jockel71/RGB_HDMI_A600/AMIGA225.JPG

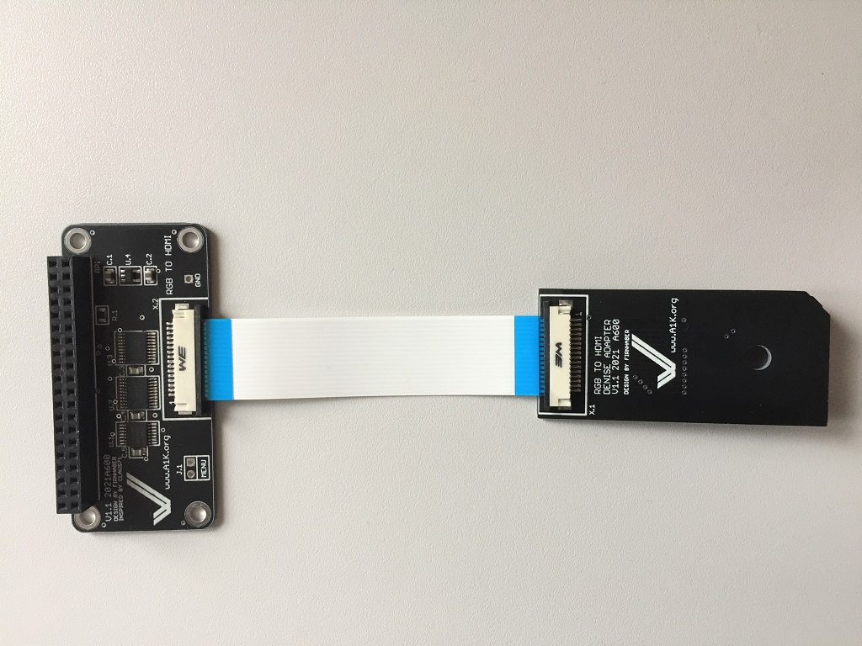
AMIGA225.JPG
