jockel71/RGB_HDMI_A600/AMIGA232.JPG

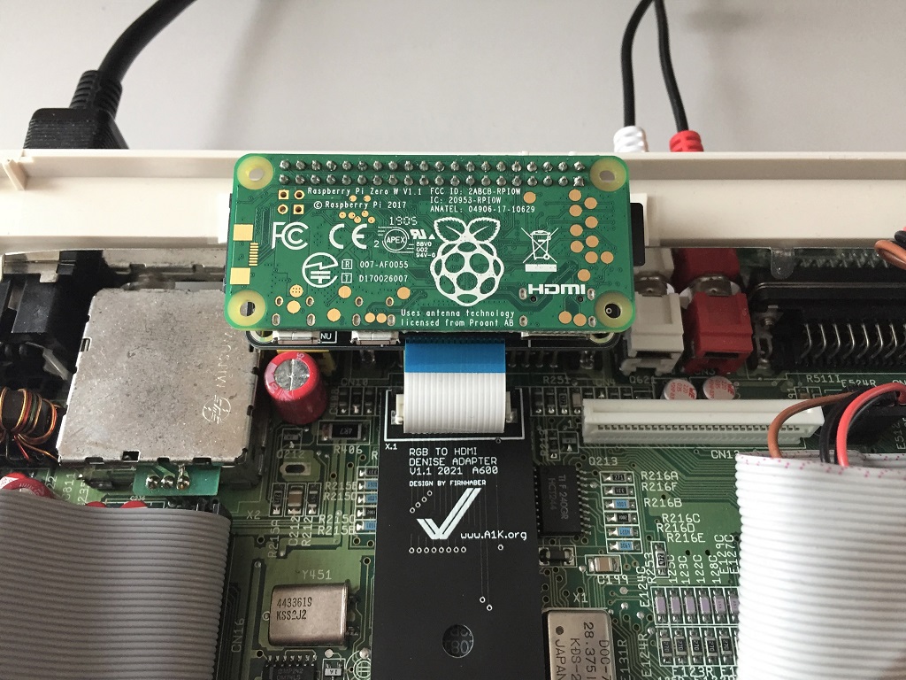
AMIGA232.JPG
