jockel71/RGB_HDMI_A600/AMIGA233.JPG

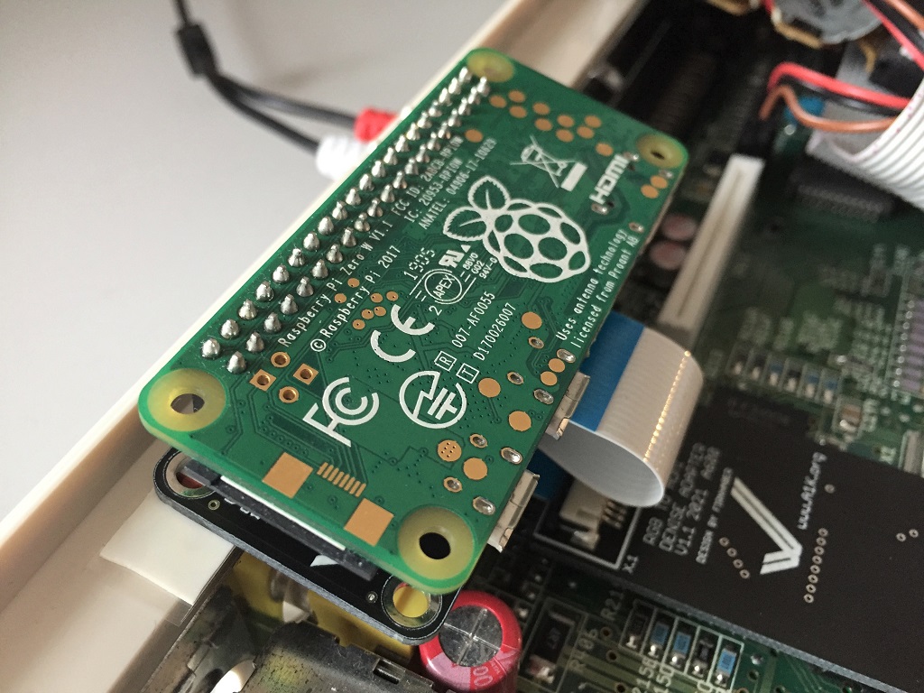
AMIGA233.JPG
