jockel71/RGB_HDMI_A600/Rev1_3/BOM_JLC.xlsx

Comment | Designator | Footprint | Mouser
10µF/10V | C.1, C.2 | 0805
100nF | C.3, C.4, | 0805
3k3 | R.1 | 0805
74LVC86APW | U.1 | TSSOP14 | 771-74LVC86APW-T
74LVC574APW | U.2, U.3 | TSSOP20 | 771-74LVC574APW-T
MIC5504-3.3M5-TR | U.4 | SOT23-5 | 998-MIC5504-3.3YM5TR
16 Pol | X.1, X.2 | FPC Header RM 1.0 | 649-F52R-1A7H1-11016
