jockel71/RGB_HDMI_A600/Rev1_3/BOM.xlsx

Menge | Wert | Device | Bauteile | Mouser
2 | 10µF/10V | 0805 | C.1, C.2
3 | 100nF | 0805 | C.3, C.4,
1 | 2 Pin | Pin Header 2.54 90°angle | J.1
1 | 3k3 | 0805 | R.1
1 | 40 Pin | 2 Row RPI Header | RPI | 710-61304021821
1 | 74LVC86APW | TSSOP14 | U.1 | 771-74LVC86APW-T
2 | 74LVC574APW | TSSOP20 | U.2, U.3 | 771-74LVC574APW-T
1 | MIC5504-3.3M5-TR | SOT23-5 | U.4 | 998-MIC5504-3.3YM5TR
1 | 52 Pin | PLCC socket SMD | U.5 | 517-8452-21A1-RK-TP
2 | 16 Pol | FPC Header RM 1.0 | X.1, X.2 | 649-F52R-1A7H1-11016
1 | 16 Pin | FPC Kabel RM 1.0 (127mm) |  | 538-15167-0319
