jockel71/RGB_HDMI_A600/HDMI_Acryl.DXF

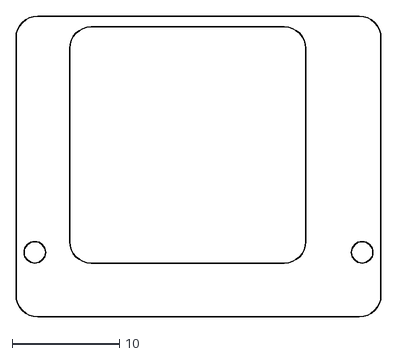
[picture p4: CAD file, 2021-08-13]
HDMI_Acryl.DXF
34.0 x 28.0
