jockel71/RGB_HDMI_A600/REV1.1/RGB_HDMI_schematic.pdf

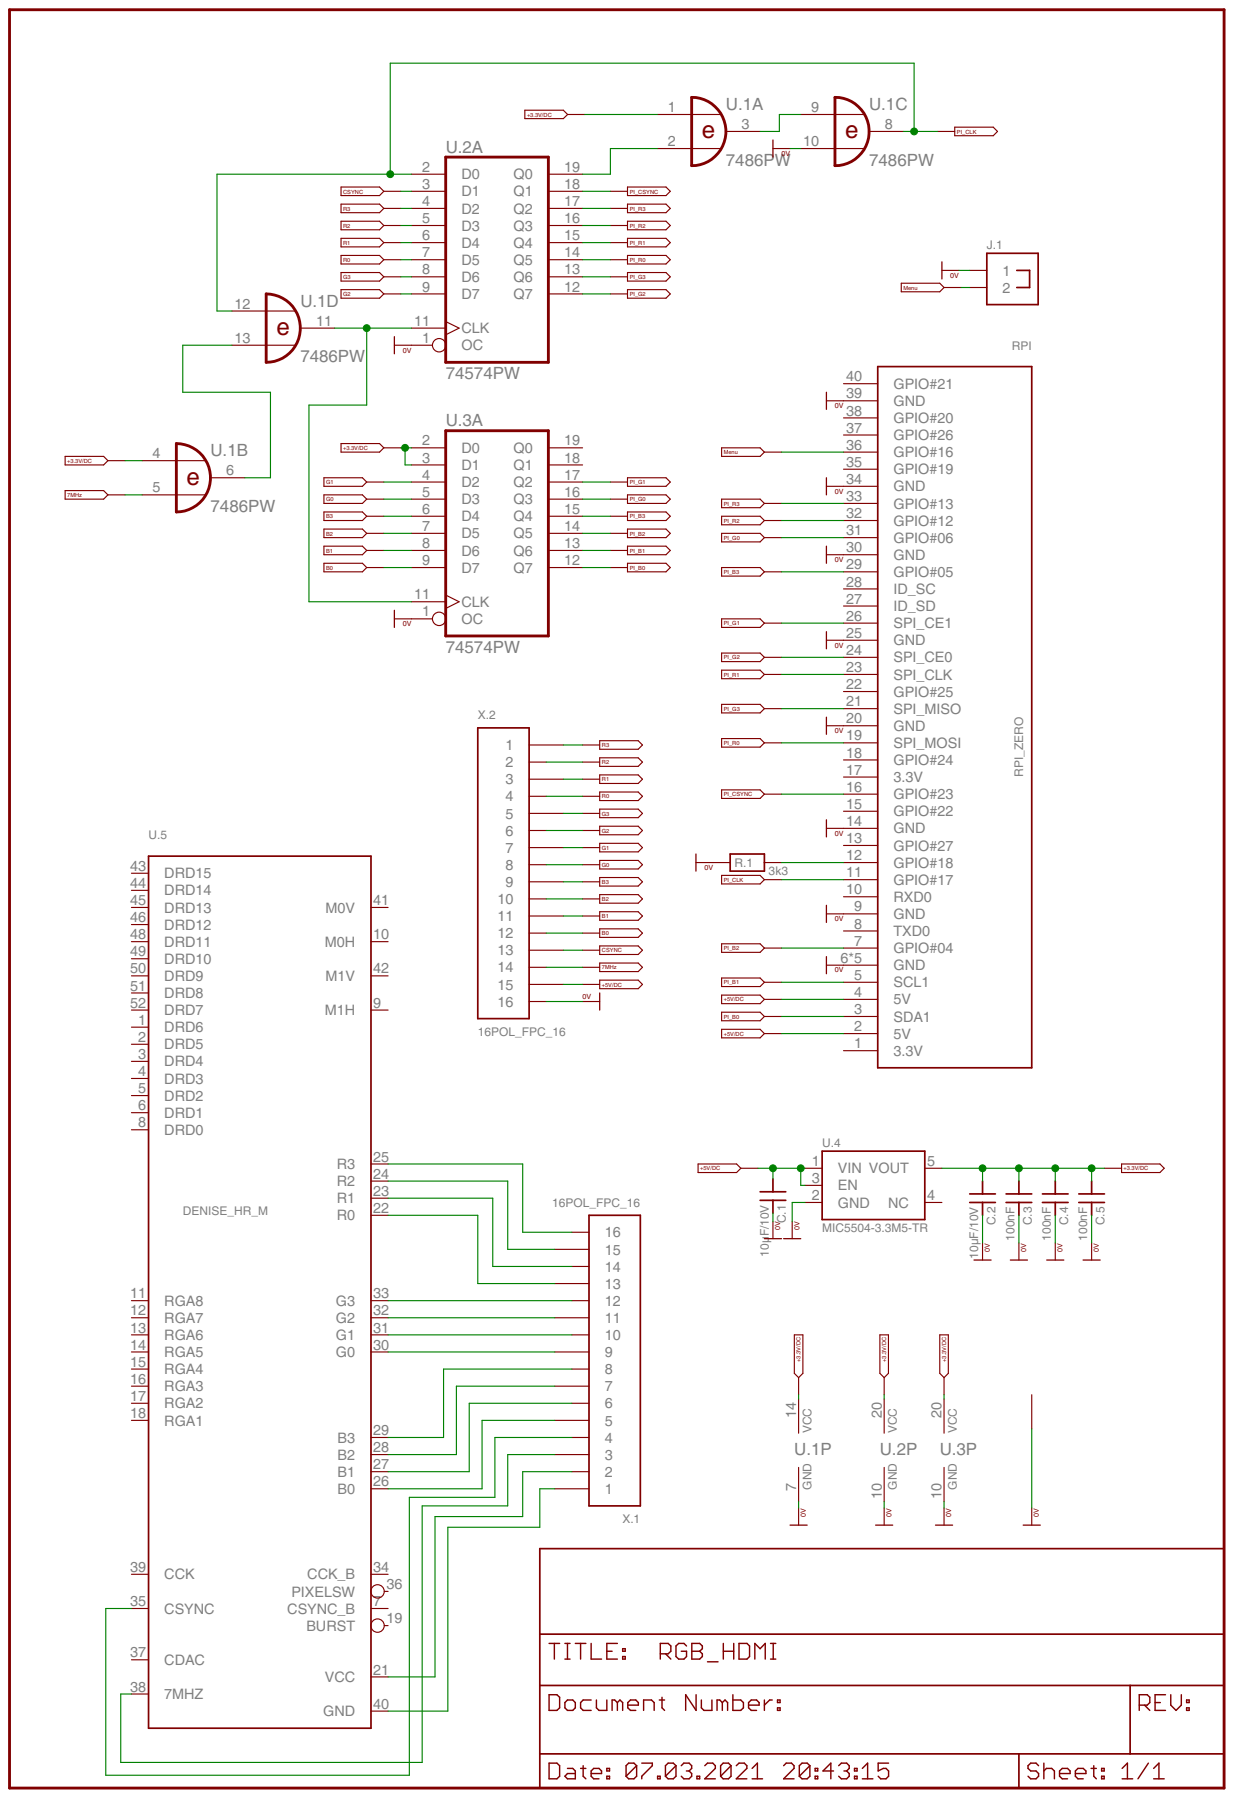
[picture p5: page 1]
