jockel71/RGB_HDMI_A600/Rev1_3/RGB_HDMI.brd

## EAGLE design Rev1_3/RGB_HDMI.brd (2021-07-07)

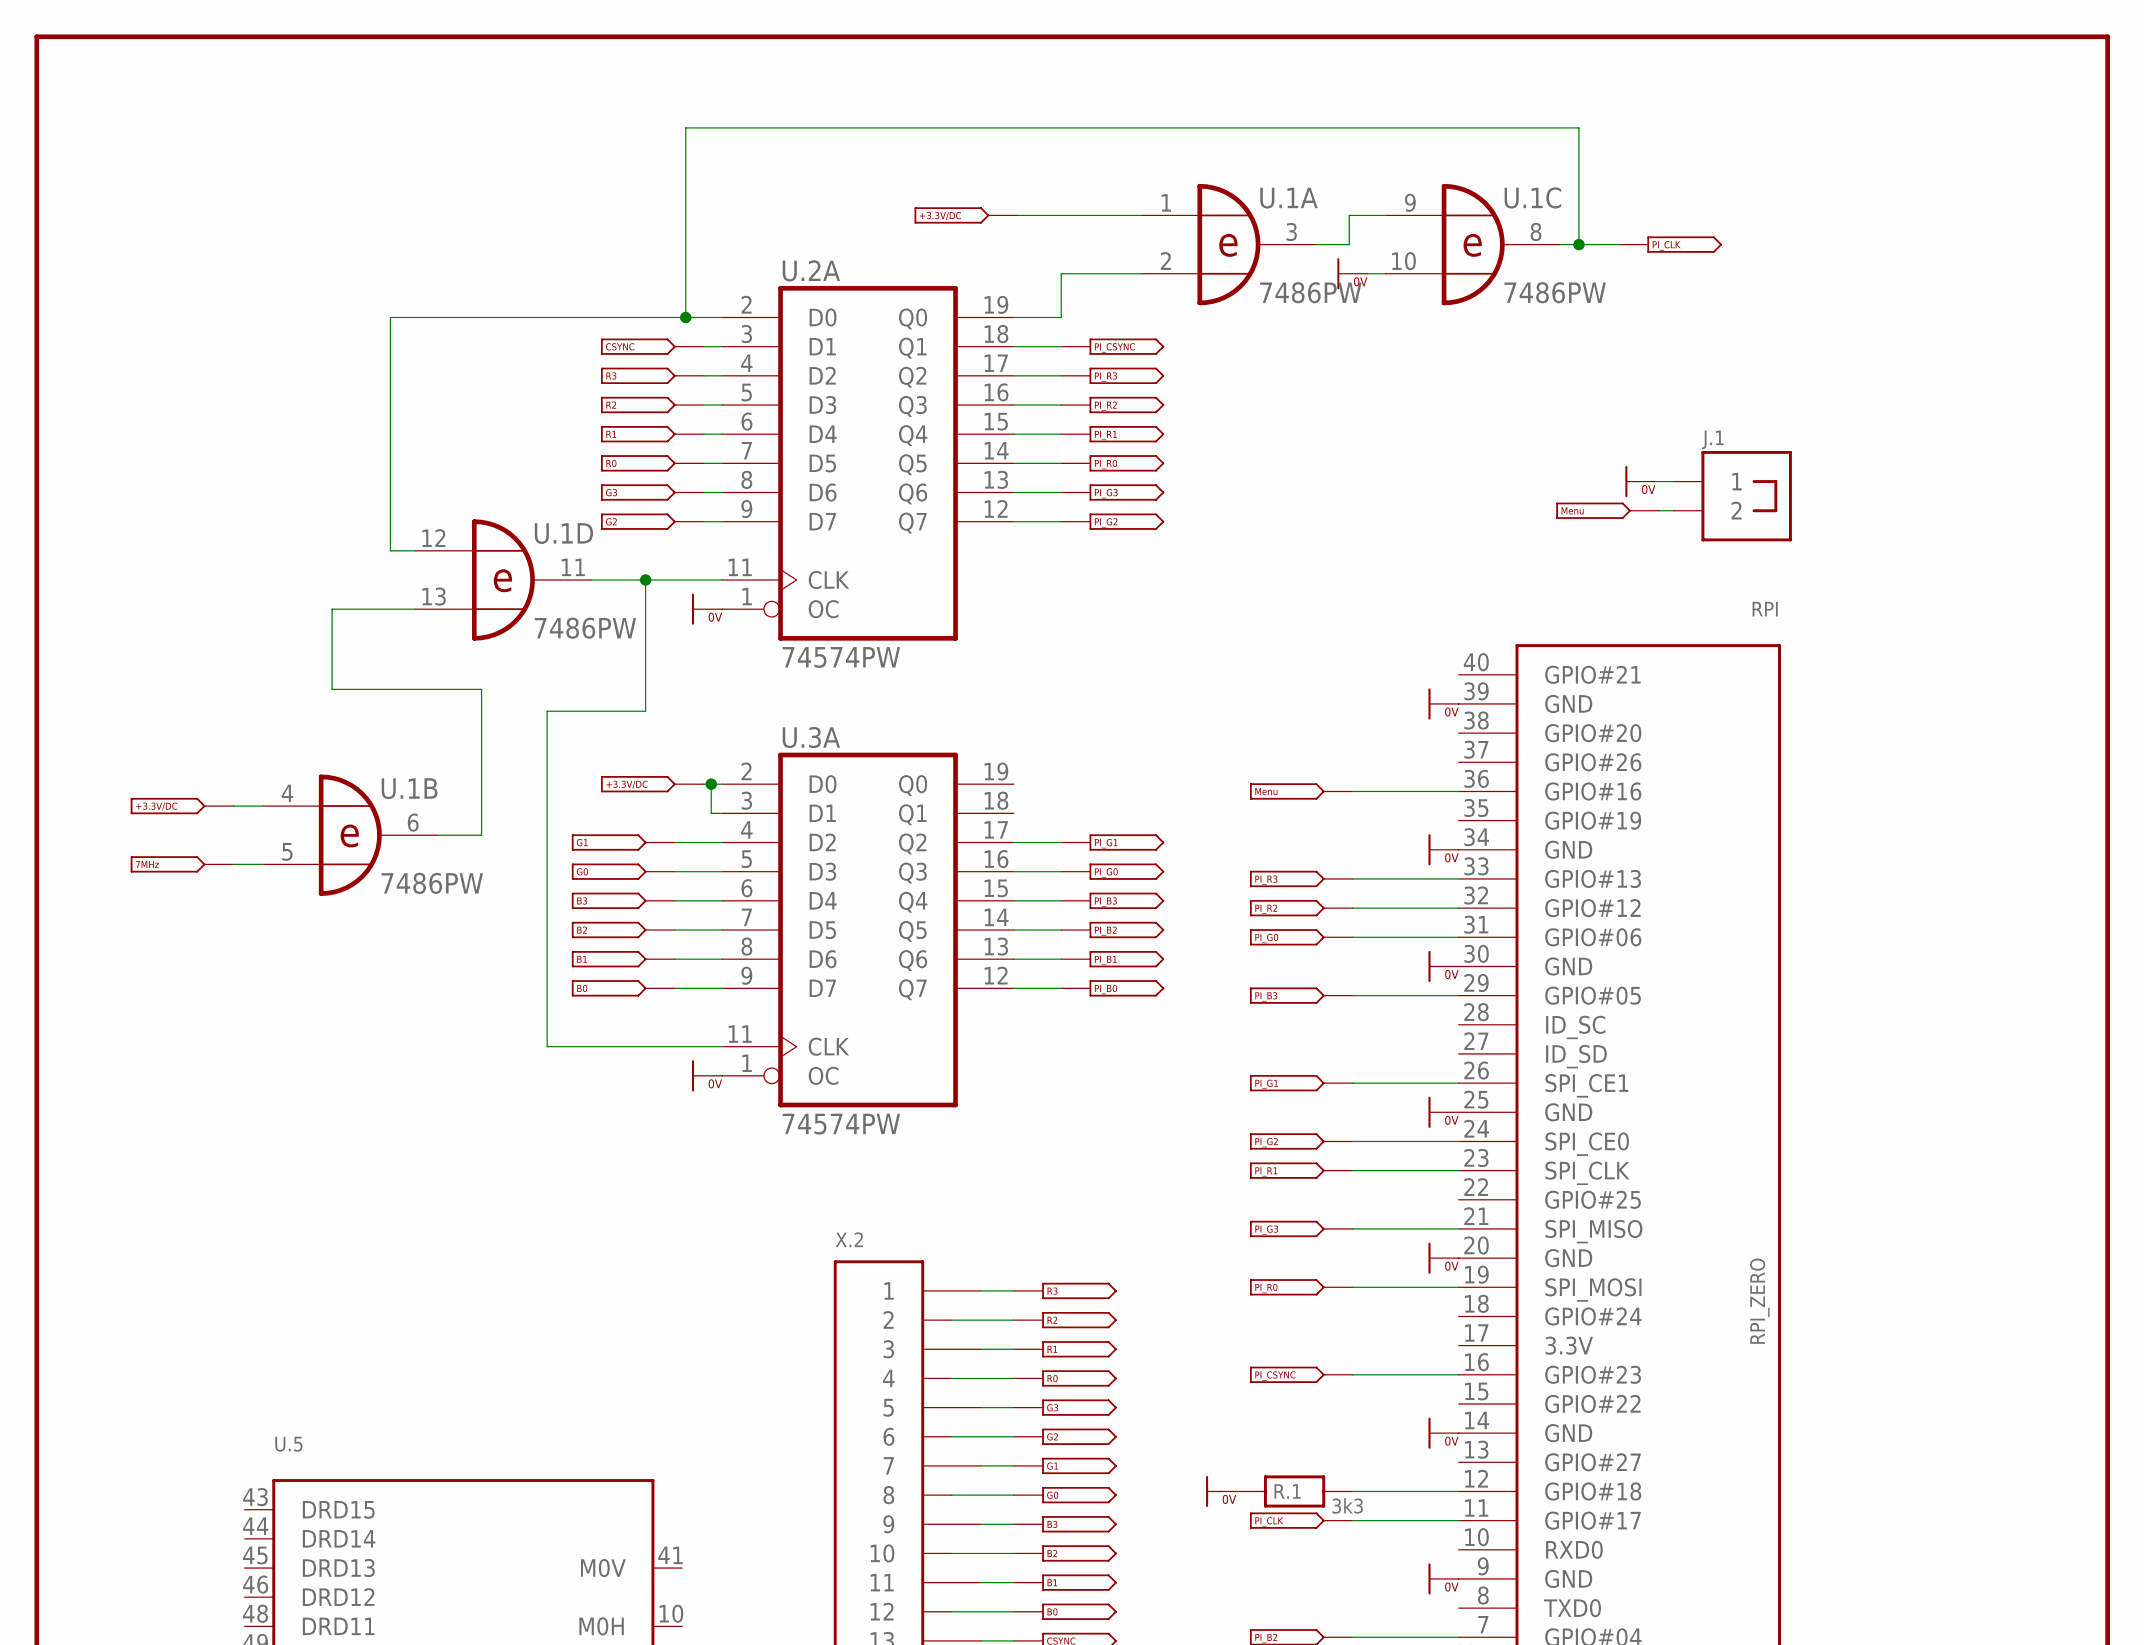
[picture p6: schematic RGB_HDMI.sch, part in row 1, column 1]

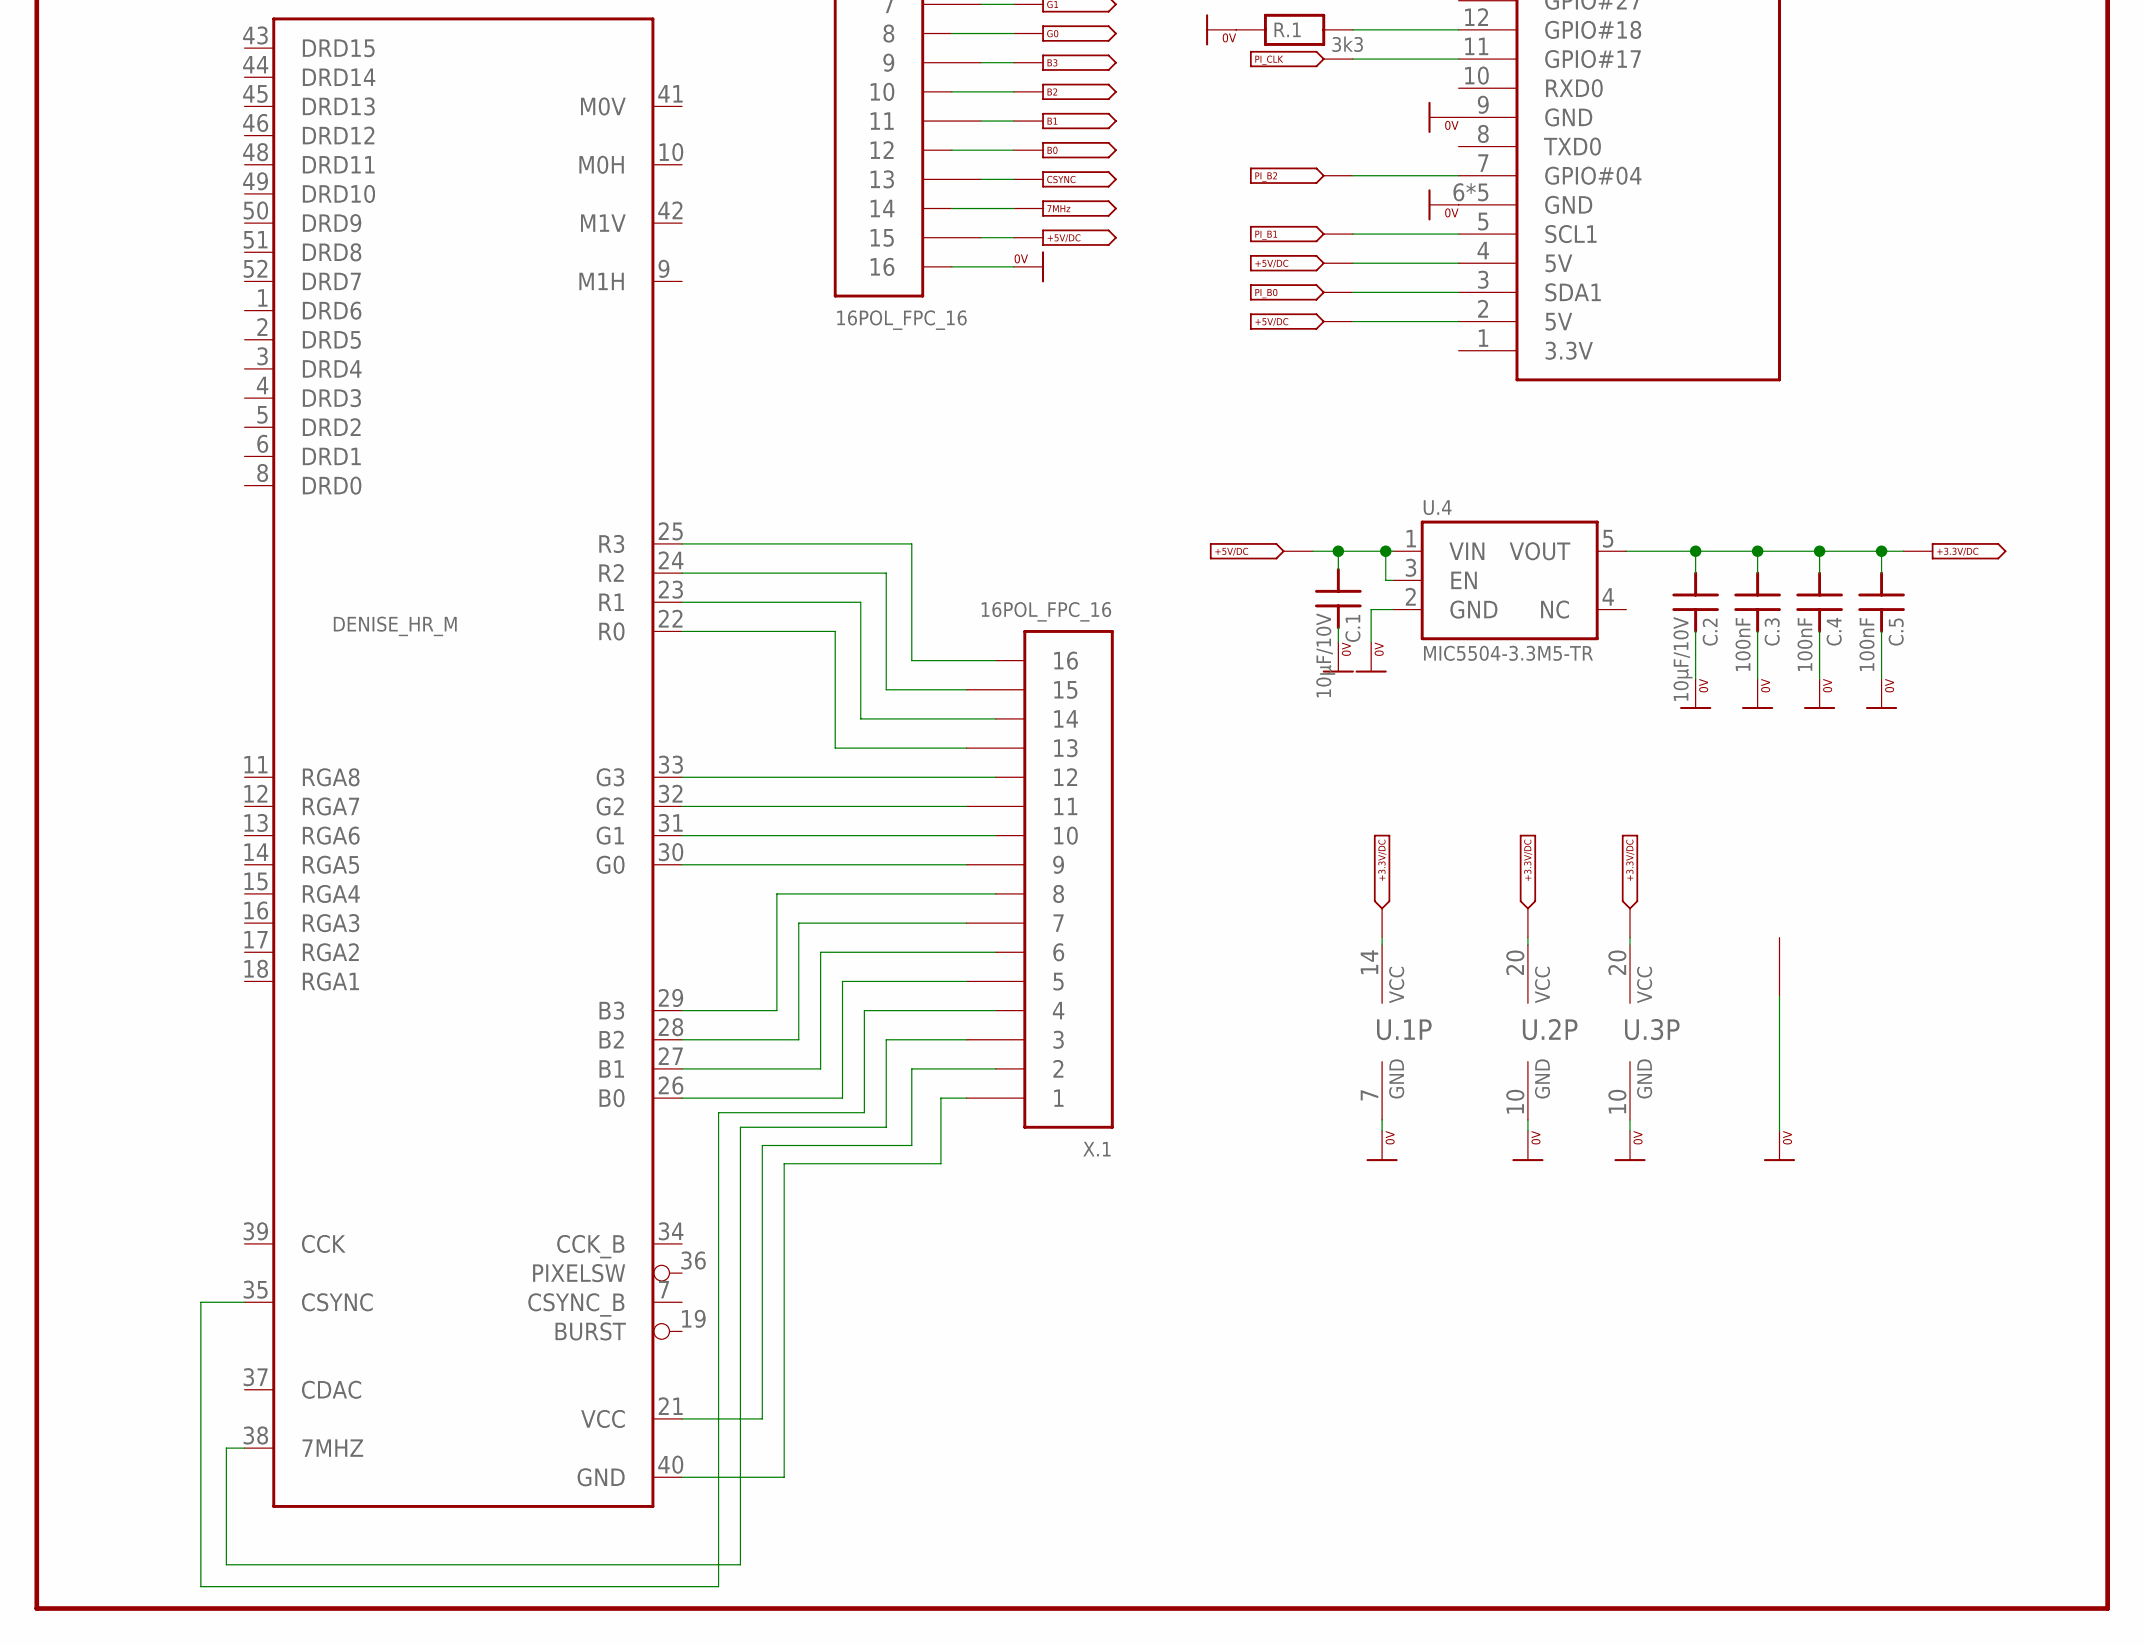
[picture p7: schematic RGB_HDMI.sch, part in row 2, column 1]

Parts:
C.1, C.2: 10µF/10V; 0805
C.3, C.4, C.5: 100nF; 0805
J.1: 2POLIG_1REIHIG
K.1: PAD_1,0SQ; 1,0SQ
R.1: 3k3; 0805
RPI: RPI_ZERO; RPI_ZERO_FULL
U.1: 7486PW; TSSOP14
U.2, U.3: 74574PW; TSSOP20
U.4: MIC5504-3.3M5-TR; SOT23-5
U.5: DENISE_HR_M; PLCC_52_MIRROR
X.1, X.2: 16POL_FPC_16; MOLEX_FPC_16

Connections:
0V: C.1.2, C.2.2, C.3.2, C.4.2, C.5.2, J.1.1, K.1.P$1, R.1.1, RPI.6 (GND), RPI.9 (GND), RPI.14 (GND), RPI.20 (GND), RPI.25 (GND), RPI.30 (GND), RPI.34 (GND), RPI.39 (GND), RPI.P$1 (GND), RPI.P$2 (GND), RPI.P$3 (GND), RPI.P$4 (GND), U.1.7 (GND), U.1.10 (I1), U.2.1 (OC), U.2.10 (GND), U.3.1 (OC), U.3.10 (GND), U.4.2 (GND), X.2.16
7MHZ: U.1.5 (I1), X.2.14
+3.3V: C.2.1, C.3.1, C.4.1, C.5.1, U.1.1 (I0), U.1.4 (I0), U.1.14 (VCC), U.2.20 (VCC), U.3.2 (D0), U.3.3 (D1), U.3.20 (VCC), U.4.5 (VOUT)
+5V: C.1.1, RPI.2 (5V), RPI.4 (5V), U.4.1 (VIN), U.4.3 (EN), X.2.15
B0: U.3.9 (D7), X.2.12
B1: U.3.8 (D6), X.2.11
B2: U.3.7 (D5), X.2.10
B3: U.3.6 (D4), X.2.9
CSYNC: U.2.3 (D1), X.2.13
G0: U.3.5 (D3), X.2.8
G1: U.3.4 (D2), X.2.7
G2: U.2.9 (D7), X.2.6
G3: U.2.8 (D6), X.2.5
GND: U.5.40 (GND), X.1.1
MENUE: J.1.2, RPI.36 (GPIO#16)
unnamed: U.1.6 (O), U.1.13 (I1)
unnamed: U.5.25 (R3), X.1.16
unnamed: U.5.24 (R2), X.1.15
unnamed: U.5.23 (R1), X.1.14
unnamed: U.5.22 (R0), X.1.13
unnamed: U.1.11 (O), U.2.11 (CLK), U.3.11 (CLK)
unnamed: U.1.2 (I1), U.2.19 (Q0)
unnamed: U.1.3 (O), U.1.9 (I0)
unnamed: U.5.30 (G0), X.1.9
unnamed: U.5.31 (G1), X.1.10
unnamed: U.5.32 (G2), X.1.11
unnamed: U.5.33 (G3), X.1.12
unnamed: U.5.29 (B3), X.1.8
unnamed: U.5.28 (B2), X.1.7
unnamed: U.5.27 (B1), X.1.6
unnamed: U.5.26 (B0), X.1.5
unnamed: U.5.21 (VCC), X.1.2
unnamed: U.5.38 (7MHZ), X.1.3
unnamed: U.5.35 (CSYNC), X.1.4
unnamed: R.1.2, RPI.12 (GPIO#18)
PI_B0: RPI.3 (SDA1), U.3.12 (Q7)
PI_B1: RPI.5 (SCL1), U.3.13 (Q6)
PI_B2: RPI.7 (GPIO#04), U.3.14 (Q5)
PI_B3: RPI.29 (GPIO#05), U.3.15 (Q4)
PI_CLK: RPI.11 (GPIO#17), U.1.8 (O), U.1.12 (I0), U.2.2 (D0)
PI_CSYNC: RPI.16 (GPIO#23), U.2.18 (Q1)
PI_G0: RPI.31 (GPIO#06), U.3.16 (Q3)
PI_G1: RPI.26 (SPI_CE1), U.3.17 (Q2)
PI_G2: RPI.24 (SPI_CE0), U.2.12 (Q7)
PI_G3: RPI.21 (SPI_MISO), U.2.13 (Q6)
PI_R0: RPI.19 (SPI_MOSI), U.2.14 (Q5)
PI_R1: RPI.23 (SPI_CLK), U.2.15 (Q4)
PI_R2: RPI.32 (GPIO#12), U.2.16 (Q3)
PI_R3: RPI.33 (GPIO#13), U.2.17 (Q2)
R0: U.2.7 (D5), X.2.4
R1: U.2.6 (D4), X.2.3
R2: U.2.5 (D3), X.2.2
R3: U.2.4 (D2), X.2.1

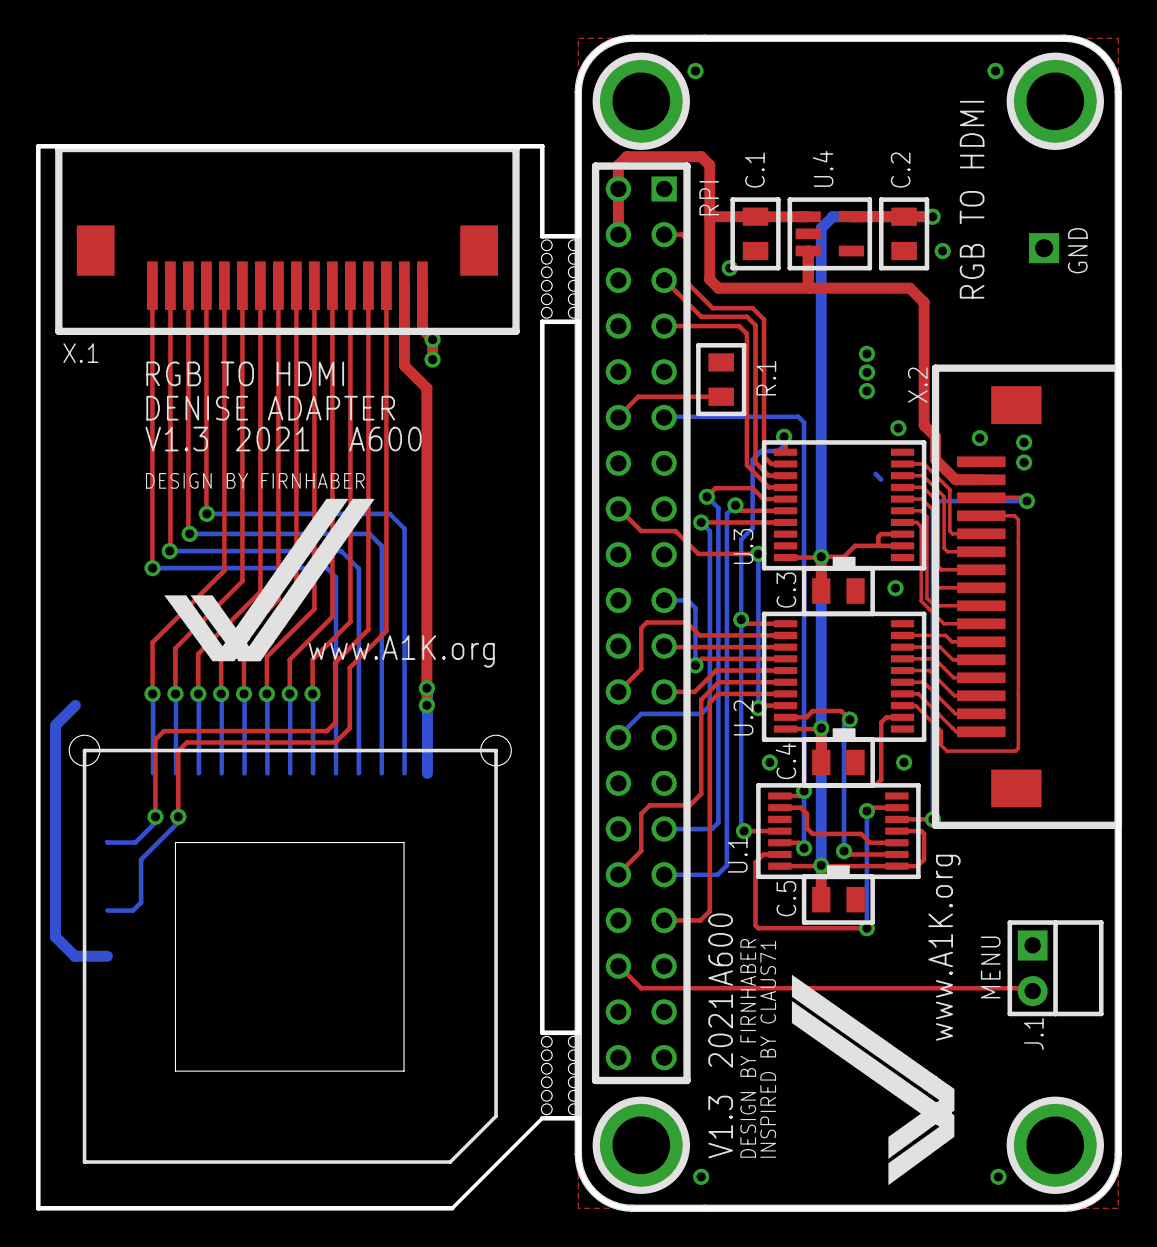
[picture p8: board RGB_HDMI.brd from above]

Board: 2 copper layers, 60.0 x 65.0 mm, 16 parts (1 on the bottom side), 53 nets.
