jockel71/RGB_HDMI_A600/(threads)

Thread 1 (2021-08-10):

Sequence

Tripod123, 2021-08-10:
Hi Jokel71.

I am trying to get the board created here in Australia however my supplier is looking for further information before they can build the board.

I have supplied them the Gerber files (Thankyou so much for designing them) but they are asking for the sequence

jockel71, 2021-08-11:
Hello Tripod123

i don´t know what he is searching for. Everything you need to built an adapter is supportet here.
The BOM.XLS is in the folder of the revision 1.1

Maybe you can explain what is missing.

jockel71, 2021-08-12:
Hi Paul

I added the sequenze.txt in the folder V1.3
Hopefully thats what he is searching for.

Tripod123, 2021-08-13:
Hi Jockel,

i think that has sorted it thank you so much for the assistance.

Final question (I Hope) the little plastic base you had for the hdmi socket to sit in with the 2 screw holes.

do you have any information for that ?

________________________________

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

jockel71, 2021-08-13:
Hi Paul

I added the dxf file for the arcyl plate. I have no 3D file!

Tripod123, 2021-08-13:
Absolute legend thanks

Get Outlook for Android<https://aka.ms/AAb9ysg>

________________________________
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

AgentK88, 2021-09-03:
Hi @Tripod123

Did you manage to get the PCBs printed? I'm looking to do the same but I can only get a price for 5 being produced which seems a little unnecessary as I hope that I would only need one.

Does anyone know if there is a way to group buy these PCBs to share cost of production?

@jockel71 Apologies for the hijacking of this issue. I'm not sure if I should have opened an issue myself or take alternative action.

Tripod123, 2021-09-05:
Hi Kevin,

I have 5 and with all components for 5 kits I am at about $400 USD so  its not a cheap excersise. I am hoping to sell the remaining 4 kits once I manage to get them all built so will let you know. Will be looking at around $100 USD plus P&P per kit. Which will be direct plug and play including the Raspberry PI and SD card with software.

Sent from Mail<https://go.microsoft.com/fwlink/?LinkId=550986> for Windows

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

jockel71, 2021-09-06:
Why is it so expensive for only 5 pcs.When you order the PCB's by "PCBWay" they will cost only 20$ plus shipping.The material for the 5 will cost 50$ - 80$ so at least one pcs will cost 25$!Von meinem/meiner Galaxy gesendet
-------- Ursprüngliche Nachricht --------Von: Tripod123 ***@***.***> Datum: 06.09.21  01:35  (GMT+01:00) An: jockel71/RGB_HDMI_A600 ***@***.***> Cc: jockel71 ***@***.***>, Mention ***@***.***> Betreff: Re: [jockel71/RGB_HDMI_A600] Sequence (#1)

Hi Kevin,

I have 5 and with all components for 5 kits I am at about $400 USD so  its not a cheap excersise. I am hoping to sell the remaining 4 kits once I manage to get them all built so will let you know. Will be looking at around $100 USD plus P&P per kit. Which will be direct plug and play including the Raspberry PI and SD card with software.

Sent from Mail<https://go.microsoft.com/fwlink/?LinkId=550986> for Windows

From: Kevin ***@***.***>

Sent: Saturday, 4 September 2021 1:15 AM

To: ***@***.***>

Cc: ***@***.***>; ***@***.***>

Subject: Re: [jockel71/RGB_HDMI_A600] Sequence (#1)

Hi @Tripod123<https://github.com/Tripod123>

Did you manage to get the PCBs printed? I'm looking to do the same but I can only get a price for 5 being produced which seems a little unnecessary as I hope that I would only need one.

Does anyone know if there is a way to group buy these PCBs to share cost of production?

@jockel71<https://github.com/jockel71> Apologies for the hijacking of this issue. I'm not sure if I should have opened an issue myself or take alternative action.

—

You are receiving this because you were mentioned.

Reply to this email directly, view it on GitHub<https://github.com/jockel71/RGB_HDMI_A600/issues/1#issuecomment-912613982>, or unsubscribe<https://github.com/notifications/unsubscribe-auth/AVEMTQQSK2HK5FXXYXPC6W3UADRCJANCNFSM5B3S63CA>.

Triage notifications on the go with GitHub Mobile for iOS<https://apps.apple.com/app/apple-store/id1477376905?ct=notification-email&mt=8&pt=524675> or Android<https://play.google.com/store/apps/details?id=com.github.android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>.

—You are receiving this because you were mentioned.Reply to this email directly, view it on GitHub, or unsubscribe.Triage notifications on the go with GitHub Mobile for iOS or Android.

Tripod123, 2021-09-06:
So pcbway charge 50 plus shipping which was another 30. When you go through the process with them it's not as cheap as they advertise.

Then you have all the components and having to get them from different  suppliers adding more freight.

Then you have the raspberry pi stuff so the pi itself is like 20 shipped Then the hdmi sockets are 10 each and a cable at 5 each.

Then you need sd cards which are 10 each.

It all adds up

Get Outlook for Android<https://aka.ms/AAb9ysg>
________________________________
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

AgentK88, 2021-09-25:
> Hi Paul
>
> I added the dxf file for the arcyl plate. I have no 3D file!

Did anyone manage to convert the dxf file to an stl file or something similar so it can be printed?

AgentK88, 2021-09-25:
I found this is anyone is interested

[Amiga 600 HDMI mount](https://www.thingiverse.com/thing:4945135)

krug3rf, 2021-10-15:
I made my own 3D model ;)
https://cults3d.com/en/3d-model/various/amiga-600-rgb2hdmi

> I found this on Thingiverse if anyone is interested
>
> [Amiga 600 HDMI mount](https://www.thingiverse.com/thing:4945135)

Thread 2 (2022-01-11):

CPL files for SMD mounting at PCB vendor

Banos1337, 2022-01-11:
Hi! Thanks for this awesome design. I really want to use your design in mine and some friends 600s.

We are unfortunately not that into smd soldering, and are going to order partially SMT Assembly from JLCPCB. JLCPCB request a file called The CPL (Component Placement List). (File,Only accept XLS,XLSX,CSV.)

Dont know why this is needed as the gerber files is uploaded.. (I am new to this)
Is this something you can add to project?

Thanks!

Cheers
Jarle

jockel71, 2022-01-12:
I put the SMD mounting File into the REV1.3
RGB_HDMI.mnt

Banos1337, 2022-01-12:
> I put the SMD mounting File into the REV1.3 RGB_HDMI.mnt

Thanks for quick response.
Format was not accepted by PCB supplier. Is it possible for you format this in same way as in the example from JLCPCB?

Designator | Mid X | Mid Y | Layer | Rotation
C1 | 95.0518mm | 22.6822mm | Top | 270
C2 | 106.4056mm | 23.0124mm | Top | 90
C3 | 109.0726mm | 22.8854mm | Top | 270
R2 | 109.5996mm | 16.6443mm | Bottom | 0

Cheers Jarle

jockel71, 2022-01-12:
I put 2 more files that can read by JLC PCB.
But you have to choose some components by your own.
BOM_JLC.xlsx
RGB_HDMI_Mount.xlsx

jockel71, 2022-01-12:
Yes this resistor will fit
